hydazz/iasis/hardware/case/README.md

# Iasis case

A printed case with a screw-fastened lid and captive button. Choose a plain lid or one for an Adafruit 938 STEMMA QT OLED. The longer CM5 version holds the main board and carrier together.

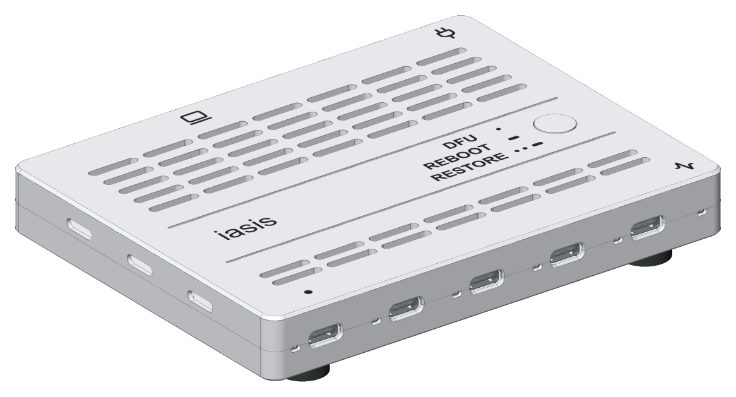
[picture p1: hardware/case/preview/case.png]
Iasis enclosure


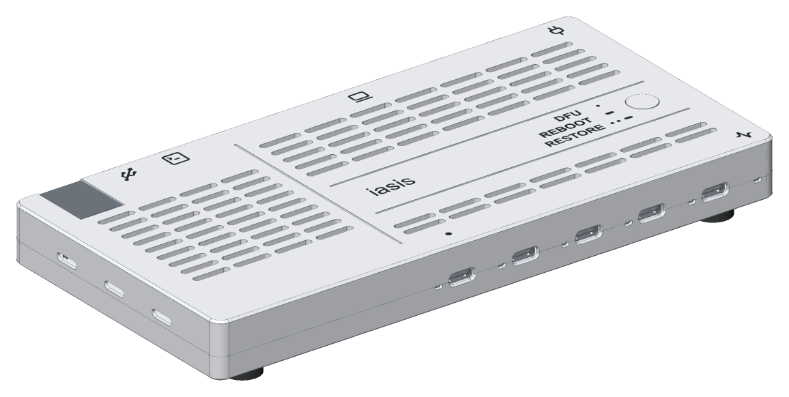
[picture p2: hardware/case/preview/case-cm5.png]
Iasis CM5 enclosure


| Case | Printed body size |
| --- | --- |
| Main board, plain lid | 136 × 104.6 × 17.1 mm |
| Main board, OLED lid  | 136 × 104.6 × 19.6 mm |
| CM5, plain lid | 212.6 × 104.6 × 20.1 mm |
| CM5, OLED lid | 212.6 × 104.6 × 20.1 mm |

## Generate the parts

Install the [development tools](../../README.md#build), including KiCad 10, then run from the repository root:

```sh
mise run //hardware/case:build
```

The build exports both populated boards and writes the case parts to `build/case/iasis/`:

| File | Part / print orientation |
| --- | --- |
| `print/tray.stl` | Tray, floor down |
| `print/cover-passive.stl` / `print/cover-display.stl` | Lid, top down |
| `print/button-passive.stl` / `print/button-display.stl` | Matching button, face down |
| `print/cover-*-lettering.stl` | Optional aligned lid inlays |
| `print/cm5-*.stl` | Corresponding CM5 parts; uses the same feet |
| `iasis-case.step` / `iasis-cm5-case.step` | Assemblies with both lid options |

The STLs are already oriented for printing. The STEP assemblies include screw, nut and purchased-foot envelopes; these are not printed parts.

## Hardware

Both sizes use the same hardware.

| Quantity | Part |
| --- | --- |
| 4 | M3 × 15 mm pan-head screws and M3 hex nuts |
| 4, OLED only | M2.5 × 4 mm pan-head screws |
| 4 | Small self-adhesive rubber feet |

Use the listed screw lengths to avoid reaching the lid's outer face.

## Print and assemble

Use PLA, a 0.4 mm nozzle, 0.20 mm layers and no supports. For multicolour markings, import the lid and matching lettering STL as parts of one object, retain their positions and assign filaments. Omit the lettering STL for recessed text.

1. Slide four M3 nuts into the inward-facing slots in the lid's outer mounting posts.
2. Set the PCB on the tray's locating pegs and fit the button from inside the lid.
3. Lower the lid onto the tray, engaging the end guides. Keep the nuts seated while handling the lid.
4. Fit the four 15 mm screws from underneath. Tighten by hand until the seam closes; the screws fasten the shell without clamping the PCB.
5. Stick four rubber feet near the corners of the flat underside, leaving the screw heads accessible.

To open, remove the four underside screws and lift the lid straight up. The feet provide clearance beneath the screw heads and can stay attached. The empty case also closes without the PCB. BOOTSEL and RESET are under the lid. The dot marks port 1; [button gestures](../../README.md#use) are printed beside the button.

### OLED assembly

With the lid face down, place the OLED on its four mounting posts, with the flex edge toward the target ports. Fit four M2.5 × 4 mm screws through the PCB's corner holes into the printed posts. Tighten gently by hand until the PCB is held against the supports. Keep pressure off the glass.

Connect the Qwiic cable before closing. The display can stay attached when opening the case.

### CM5 assembly

| Cooler fit | Dimension |
| --- | --- |
| Model | Waveshare CM4-HEATSINK, SKU 19623 |
| Body | 55 × 40 × 5 mm |
| Mounting allowance above module PCB | 3 mm |

Check the cooler's spacers and thermal-pad contact before assembly. Taller spacers need a taller lid.

Disconnect power before assembly or removal.

1. Fit the cooler screws from below.
2. Stick the RTC battery into the tray recess. Route its cable along the channel and pass the plug between the boards before joining them.
3. Align the boards' rear edges and connector pins, join the boards and lower them onto the pegs. Keep the wires side by side in the board gap.
4. Connect the battery to J104, tuck the cable clear of the lid and [enable charging](../boards/cm5/README.md#rtc-battery).

To remove the battery, unplug J104 and separate the boards before feeding the plug back through the gap.

## CAD tools

The case is generated with build123d. These tasks use the root Python environment:

| Task | Purpose |
| --- | --- |
| `mise run //hardware/case:test` | Check solids, board clearances, USB access and moving parts |
| `mise run //hardware/case:preview`  | Refresh the two images; requires a working graphics driver  |
| `mise run //hardware/case:view` | Open in OCP CAD Viewer |
| `mise run //hardware/case:view-cm5` | Open the CM5 assembly |

In the viewer, show one lid at a time under Cover. The [Lucide icons](src/iasis_case/icons/NOTICE) retain their licence and source notices.
