hydazz/iasis/hardware/boards/cm5/board.png

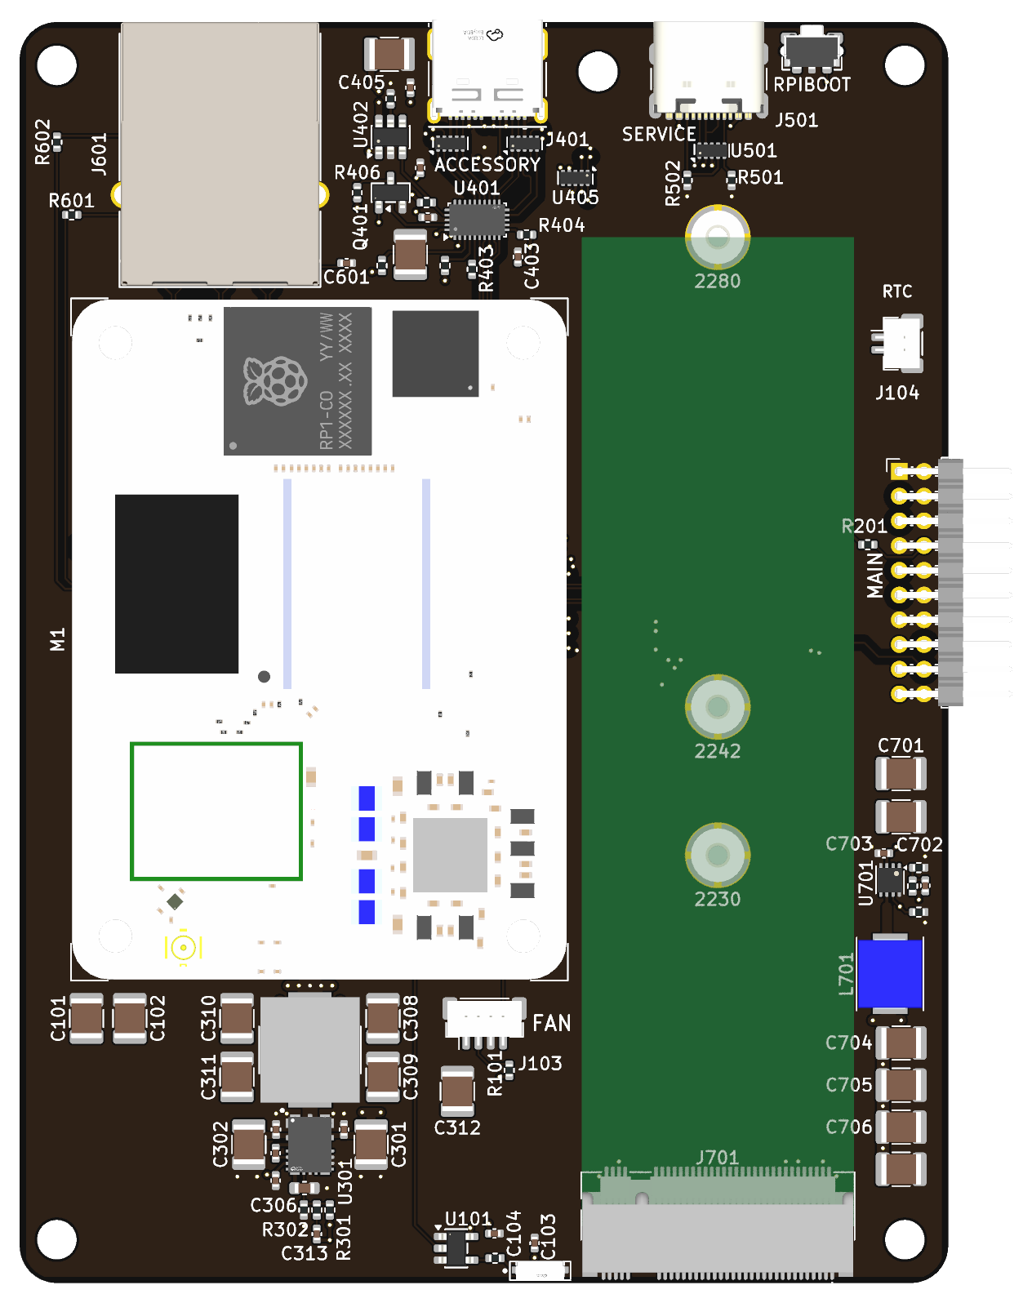
hardware/boards/cm5/board.png
