hydazz/iasis/hardware/tools/jlc_corrections.csv

lcsc | footprint | rotation | x | y
C134092 | Connector_USB:USB_C_Receptacle_Molex_105450-0101 | 0 | 0.0 | -0.334
C5184243 | Iasis:GCT_USB4105_GF_A_120 | 0 | 0.0 | -1.302
C8545 | Package_TO_SOT_SMD:SOT-23 | 180 | 0 | 0
C22466768 | Package_SO:Vishay_PowerPAK_1212-8_Single | 270 | -0.538226 | -0.016637
C7422903 | Package_SO:Vishay_PowerPAK_1212-8_Single | 270 | 0.165 | 0
C507223 | Package_TO_SOT_SMD:SOT-353_SC-70-5 | 180 | 0 | 0
C10096 | Package_TO_SOT_SMD:SOT-23-5 | 180 | 0 | 0
C544517 | Package_DFN_QFN:DHVQFN-20-1EP_2.5x4.5mm_P0.5mm_EP1x3mm | 270 | 0 | 0
C106794 | Package_SON:USON-10_2.5x1.0mm_P0.5mm | 270 | 0 | 0
C132291 | Package_DFN_QFN:WQFN-14-1EP_2.5x2.5mm_P0.5mm_EP1.45x1.45mm | 270 | 0 | 0
C2673275 | Package_DFN_QFN:UQFN-16_1.8x2.6mm_P0.4mm | 270 | 0 | 0
C3236215 | Package_TO_SOT_SMD:Texas_DDF0008A_SOT-8_1.6x2.9mm_P0.65mm | 270 | 0 | 0
C544399 | Iasis:HTSSOP-16-1EP_4.4x5mm_P0.65mm_EP3.4x5mm_Mask2.66x2.46mm_ThermalVias | 270 | 0 | 0
C2070918 | Package_DFN_QFN:DFN-8-1EP_2x2mm_P0.5mm_EP0.9x1.7mm | 270 | 0 | 0
C43698 | Package_TO_SOT_SMD:SOT-23-6 | 180 | 0 | 0
C555456 | Package_DFN_QFN:Texas_RGE0024C_VQFN-24-1EP_4x4mm_P0.5mm_EP2.1x2.1mm | 270 | 0 | 0
C7484 | Package_TO_SOT_SMD:SOT-23-5 | 180 | 0 | 0
C181499 | Package_DFN_QFN:VQFN-16-1EP_3x3mm_P0.5mm_EP1.45x1.45mm | 270 | 0 | 0
C5948 | Package_SO:TSSOP-16_4.4x5mm_P0.65mm | 270 | 0 | 0
C548572 | Package_SO:VSSOP-8_2.3x2mm_P0.5mm | 270 | 0 | 0
C2158037 | Package_TO_SOT_SMD:SOT-23-6 | 180 | 0 | 0
C3198089 | CM5:TI_RPH0016A | 0 | 0 | 0.132
C165155 | Package_DFN_QFN:Texas_RNH0030A_WQFN-30-1EP_2.5x4.5mm_P0.4mm_EP1.2x3.2mm | 270 | 0 | 0
C2158038 | Package_TO_SOT_SMD:SOT-23-6 | 270 | 0 | 0
C138714 | Package_SON:USON-10_2.5x1.0mm_P0.5mm | 270 | 0 | 0
C160390 | Connector_JST:JST_SH_BM04B-SRSS-TB_1x04-1MP_P1.00mm_Vertical | 0 | 0 | 0.062
C160388 | Connector_JST:JST_SH_BM02B-SRSS-TB_1x02-1MP_P1.00mm_Vertical | 180 | 0 | 0.062
C110293 | Button_Switch_SMD:SW_Push_1P1T-MP_NO_Horizontal_Alps_SKRTLAE010 | 0 | 0 | 0.075
C19268939 | Connector_PinSocket_2.00mm:PinSocket_2x10_P2.00mm_Horizontal | 270 | -1 | 9
C2906016 | Connector_PinHeader_2.00mm:PinHeader_2x10_P2.00mm_Horizontal | 90 | 1 | 9
C46061833 | Package_DFN_QFN:Texas_DSQ0010A_WSON-10-1EP_2x2mm_P0.4mm_EP0.9x1.5mm | 270 | 0 | 0
