hydazz/iasis/hardware/boards/cm5/cm5.kicad_pcb

## KiCad design hardware/boards/cm5/cm5.kicad_pcb (2026-11-10)

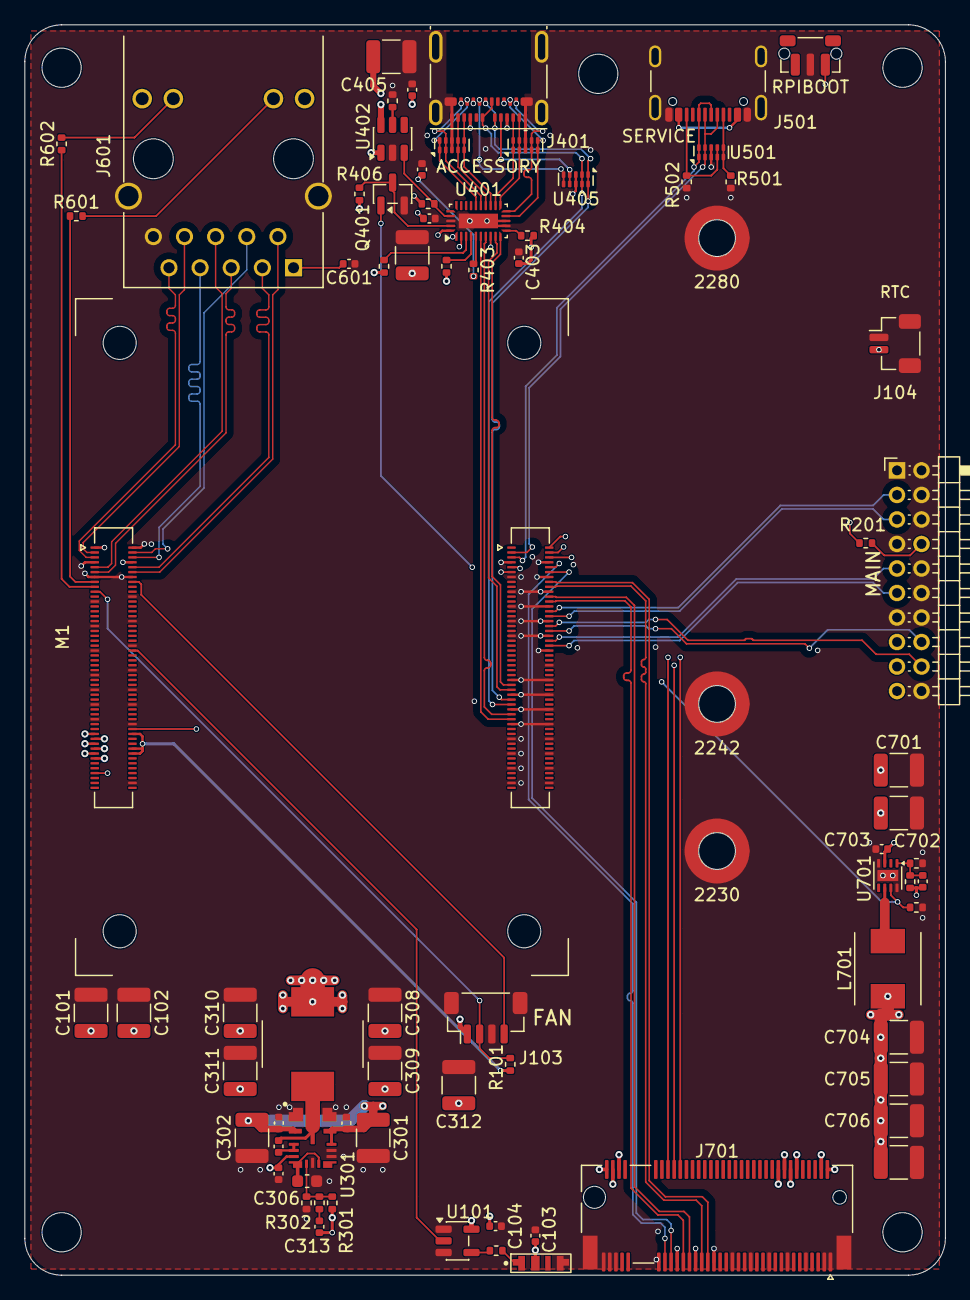
[picture p5: board cm5.kicad_pcb from above]

Board: 6 copper layers, 75.1 x 102.0 mm, 84 parts (0 on the bottom side), 79 nets.

Parts:
C101, C102, C308, C309, C310, C311, C312, C401, C405, C701, C702, C704, C705, C706, C707: 22u 16V X7R; C_1210_3225Metric
C103, C104, C305, C307, C402, C403, C404, C406, C601, C703: 100n; C_0402_1005Metric
C301, C302: 10u 50V X7R; C_1210_3225Metric
C303, C304: 100n 50V X7R; C_0402_1005Metric
C306: 1u 10V X7R; C_0603_1608Metric
C313: 10p C0G; C_0402_1005Metric
C708: 4.7n; C_0402_1005Metric
D101: SK6812SIDE-A; OPSCO_SK6812SIDE-A
H1, H2, H3, H4, H5: M3; MountingHole_3.2mm_M3
H701, H702, H703: 9774025243R; Mounting_Wuerth_WA-SMSI-M2_H2.5mm_9774025243
J101, J102: 10164227-1001A1RLF; Hirose_DF40C-100DS-0.4V_2x50_P0.4mm
J103: BM04B-SRSS-TB; JST_SH_BM04B-SRSS-TB_1x04-1MP_P1.00mm_Vertical
J104: BM02B-SRSS-TB; JST_SH_BM02B-SRSS-TB_1x02-1MP_P1.00mm_Vertical
J201: PZ200-2-10-W; PinHeader_2x10_P2.00mm_Horizontal
J401: 1054500101; USB_C_Receptacle_Molex_105450-0101
J501: USB4105-GF-A-120; GCT_USB4105_GF_A_120
J601: HR911130A; HanRun_HR911130A
J701: 1-2199230-5; TE_M.2_M_2x38-1MP_P0.5mm
L301: 3.3u 17A; L_PROD_PSPMAA0805
L701: SRP5030CC-2R2M; Bourns_SRP5030CC
M1: CM5; RaspberryPi_CM5
Q401: 2N7002; SOT-23
R101, R701: 10k; R_0402_1005Metric
R102: 33; R_0402_1005Metric
R201: 1k; R_0402_1005Metric
R301: 100k 0.1%; R_0402_1005Metric
R302: 24.3k 0.1%; R_0402_1005Metric
R303, R501, R502: 5.1k; R_0402_1005Metric
R401: 4.7k; R_0402_1005Metric
R402: 499k 1%; R_0402_1005Metric
R403: 909k 1%; R_0402_1005Metric
R404, R405: 200k 1%; R_0402_1005Metric
R406, R703: 100k; R_0402_1005Metric
R407: 15k 1%; R_0402_1005Metric
R601, R602: 470; R_0402_1005Metric
R702: 2.2k; R_0402_1005Metric
SW501: SKRTLAE010; SW_Push_1P1T-MP_NO_Horizontal_Alps_SKRTLAE010
U101: SN74AHCT1G125DBVR; SOT-23-5
U301: LM61480RPHR; TI_RPH0016A
U401: HD3SS3220RNHR; Texas_RNH0030A_WQFN-30-1EP_2.5x4.5mm_P0.4mm_EP1.2x3.2mm
U402: AP22652W6-7; SOT-23-6
U403, U404: TPD4E02B04DQAR; USON-10_2.5x1.0mm_P0.5mm
U405, U501: TPD4E05U06DQAR; USON-10_2.5x1.0mm_P0.5mm
U701: AP3441SHE-7B; DFN-8-1EP_2x2mm_P0.5mm_EP0.9x1.7mm

Connections:
5V: C101.1, C102.1, C103.1, C104.1, C307.1, C308.1, C309.1, C310.1, C311.1, C312.1, C313.1, C401.1, C402.1, C404.1, C701.1, C702.1, C703.1, D101.2 (VDD), J101.77 (5V), J101.79 (5V), J101.81 (5V), J101.83 (5V), J101.85 (5V), J101.87 (5V), J103.1, L301.2, R301.1, R401.1, R402.1, R405.1, R406.1, U101.5 (VCC), U301.5 (BIAS), U401.30 (VDD5), U402.1 (IN), U701.3 (VIN)
/5 V supply/BUCK_FB: R301.2, R302.1, R303.2, U301.7 (FB)
/5 V supply/BUCK_SW: C305.1, L301.1, U301.16 (SW)
/Accessory port/CC1: J401.A5 (CC1), U401.2 (CC1), U405.4 (D2+), U405.7 (NC)
/Accessory port/CC2: J401.B5 (CC2), U401.1 (CC2), U405.5 (D2-), U405.6 (NC)
/Accessory port/CC_EN_N: Q401.3 (D), R406.2, U401.29 (ENn_CC)
/Accessory port/CURRENT_MODE: R402.2, U401.3 (CURRENT_MODE)
/Accessory port/DIR: R404.2, U401.11 (DIR)
/Accessory port/ID: R405.2, U401.27 (ID), U402.3 (~EN)
/Accessory port/PORT: R401.2, U401.4 (PORT)
/Accessory port/RX1_N: J401.B10 (RX1-), U401.14 (RX1n), U403.5 (D2-), U403.6 (NC)
/Accessory port/RX1_P: J401.B11 (RX1+), U401.15 (RX1p), U403.4 (D2+), U403.7 (NC)
/Accessory port/RX2_N: J401.A10 (RX2-), U401.18 (RX2n), U404.5 (D2-), U404.6 (NC)
/Accessory port/RX2_P: J401.A11 (RX2+), U401.19 (RX2p), U404.4 (D2+), U404.7 (NC)
/Accessory port/TX1_N: J401.A2 (TX1+), U401.16 (TX1n), U403.2 (D1-), U403.9 (NC)
/Accessory port/TX1_P: J401.A3 (TX1-), U401.17 (TX1p), U403.1 (D1+), U403.10 (NC)
/Accessory port/TX2_N: J401.B2 (TX2+), U401.20 (TX2n), U404.2 (D1-), U404.9 (NC)
/Accessory port/TX2_P: J401.B3 (TX2-), U401.21 (TX2p), U404.1 (D1+), U404.10 (NC)
/Accessory port/VBUS_ILIM: R407.1, U402.5 (ILIM)
/Compute module/FAN_PWM: J101.19 (Fan_PWM), J103.2, R101.2
/Compute module/FAN_TACH: J101.16 (Fan_Tacho), J103.4
/Compute module/LED_DATA: J101.44 (GPIO10), U101.2
/Compute module/RTC_BAT: J101.76 (VBAT), J104.2
/NVMe/NVME_FB: C708.2, R701.2, R702.1, U701.1 (FB)
/NVMe/NVME_LX: L701.1, U701.6 (LX)
/Service port/CC1: J501.A5 (CC1), R501.1, U501.5 (D2-), U501.6 (NC)
/Service port/CC2: J501.B5 (CC2), R502.1, U501.4 (D2+), U501.7 (NC)
/Service port/VBUS_UNUSED: J501.A4 (VBUS), J501.A9 (VBUS), J501.B4 (VBUS), J501.B9 (VBUS)
/Side link/CM5_HOST: J201.8, R201.2
ACC_D_N: J102.65 (USB3-1-DM), J401.A7 (D-), J401.B7 (D-), U405.2 (D1-), U405.9 (NC)
ACC_D_P: J102.63 (USB3-1-DP), J401.A6 (D+), J401.B6 (D+), U405.1 (D1+), U405.10 (NC)
ACC_RX_N: J102.57 (USB3-1-RX_N), U401.10 (RXn)
ACC_RX_P: J102.59 (USB3-1-RX_P), U401.9 (RXp)
ACC_TX_N: J102.69 (USB3-1-TX_N), U401.7 (TXn)
ACC_TX_P: J102.71 (USB3-1-TX_P), U401.6 (TXp)
ACC_VBUS: C405.1, C406.1, J401.A4 (VBUS), J401.A9 (VBUS), J401.B4 (VBUS), J401.B9 (VBUS), R403.2, U402.6 (OUT)
CM5_3V3: C403.1, J101.78 (GPIO_VREF), J101.84 (CM5_3V3), J101.86 (CM5_3V3), J601.11 (LEDG+), J601.14 (LEDY+), R101.1, R404.1, U401.8 (VCC33)
ETH_LED2_N: J101.17 (Ethernet_nLED2), R602.2
ETH_LED3_N: J101.15 (Ethernet_nLED3), R601.2
GND: C101.2, C102.2, C103.2, C104.2, C301.2, C302.2, C303.2, C304.2, C306.2, C307.2, C308.2, C309.2, C310.2, C311.2, C312.2, C401.2, C402.2, C403.2, C404.2, C405.2, C406.2, C601.2, C701.2, C702.2, C703.2, C704.2, C705.2, C706.2, C707.2, D101.4 (GND), H701.1 (1_1), H702.1 (1_1), H703.1 (1_1), J101.1 (GND), J101.2 (GND), J101.7 (GND), J101.8 (GND), J101.13 (GND), J101.14 (GND), J101.22 (GND), J101.23 (GND), J101.32 (GND), J101.33 (GND), J101.42 (GND), J101.43 (GND), J101.52 (GND), J101.53 (GND), J101.59 (GND), J101.60 (GND), J101.65 (GND), J101.66 (GND), J101.71 (GND), J101.74 (GND), J101.98 (GND), J102.7 (GND), J102.8 (GND), J102.13 (GND), J102.14 (GND), J102.19 (GND), J102.20 (GND), J102.25 (GND), J102.26 (GND), J102.31 (GND), J102.32 (GND), J102.37 (GND), J102.38 (GND), J102.44 (GND), J102.50 (GND), J102.55 (GND), J102.56 (GND), J102.61 (GND), J102.62 (GND), J102.67 (GND), J102.68 (GND), J102.73 (GND), J102.74 (GND), J102.79 (GND), J102.80 (GND), J102.85 (GND), J102.86 (GND), J102.91 (GND), J102.92 (GND), J102.97 (GND), J102.98 (GND), J103.3, J103.MP (MountPin), J104.1, J104.MP (MountPin), J201.1, J201.2, J201.4, J201.6, J201.7, J201.10, J201.12, J201.13, J201.14, J201.20, J401.A1 (GND), J401.A12 (GND), J401.B1 (GND), J401.B12 (GND), J401.SH (SHIELD), J501.A1 (GND), J501.A12 (GND), J501.B1 (GND), J501.B12 (GND), J501.SH (SHIELD), J601.10 (CHASSIS), J601.SH, J701.1 (GND), J701.3 (GND), J701.9 (GND), J701.15 (GND), J701.21 (GND), J701.27 (GND), J701.33 (GND), J701.39 (GND), J701.45 (GND), J701.51 (GND), J701.57 (GND), J701.71 (GND), J701.73 (GND), J701.75 (GND), J701.MP (SH), Q401.2 (S), R302.2, R407.2, R501.2, R502.2, R702.2, R703.2, SW501.2, U101.1, U101.3 (GND), U301.1 (PGND2), U301.8 (AGND), U301.11 (SPSP), U301.12 (SYNC/MODE), U301.15 (PGND1), U401.12 (ENn_MUX), U401.13 (GND), U401.28 (GND), U401.31 (GND), U402.2 (GND), U403.3 (GND), U403.8 (GND), U404.3 (GND), U404.8 (GND), U405.3 (GND), U405.8 (GND), U501.3 (GND), U501.8 (GND), U701.4 (PGND), U701.8 (SGND), U701.9 (SGND)
MDI0_N: J101.10 (Ethernet_Pair0_N), J601.3 (MDI0-)
MDI0_P: J101.12 (Ethernet_Pair0_P), J601.2 (MDI0+)
MDI1_N: J101.6 (Ethernet_Pair1_N), J601.7 (MDI1-)
MDI1_P: J101.4 (Ethernet_Pair1_P), J601.4 (MDI1+)
MDI2_N: J101.9 (Ethernet_Pair2_N), J601.6 (MDI2-)
MDI2_P: J101.11 (Ethernet_Pair2_P), J601.5 (MDI2+)
MDI3_N: J101.5 (Ethernet_Pair3_N), J601.9 (MDI3-)
MDI3_P: J101.3 (Ethernet_Pair3_P), J601.8 (MDI3+)
NVME_3V3: C704.1, C705.1, C706.1, C707.1, C708.1, J701.2 (3.3V), J701.4 (3.3V), J701.12 (3.3V), J701.14 (3.3V), J701.16 (3.3V), J701.18 (3.3V), J701.70 (3.3V), J701.72 (3.3V), J701.74 (3.3V), L701.2, R701.1
unnamed: C313.2, R303.1
unnamed: D101.1 (DIN), R102.2
unnamed: C601.1, J601.1 (CT)
unnamed: J601.12 (LEDG-), R601.1
unnamed: J601.13 (LEDY-), R602.1
unnamed: R102.1, U101.4
unnamed: C305.2, U301.3 (RBOOT), U301.4 (CBOOT)
unnamed: C306.1, U301.6 (VCC), U301.9 (RT)
unnamed: R403.1, U401.5 (VBUS_DET)
OTG_D_N: J102.3 (USB_N), J501.A7 (D-), J501.B7 (D-), U501.2 (D1-), U501.9 (NC)
OTG_D_P: J102.5 (USB_P), J501.A6 (D+), J501.B6 (D+), U501.1 (D1+), U501.10 (NC)
PCIE_CLKREQ_N: J102.2 (PCIe_CLK_nREQ), J701.52 (~CLKREQ)
PCIE_CLK_N: J102.12 (PCIe_CLK_N), J701.53 (REFCLKn)
PCIE_CLK_P: J102.10 (PCIe_CLK_P), J701.55 (REFCLKp)
PCIE_PWR_EN: J102.6 (PCIE_PWR_EN), R703.1, U701.7 (EN)
PCIE_RST_N: J102.9 (PCIe_nRST), J701.50 (~PERST)
PCIE_RX_N: J102.16 (PCIe_RX_P), J701.41 (PERn0/SATA-B+)
PCIE_RX_P: J102.18 (PCIe_RX_N), J701.43 (PERp0/SATA-B-)
PCIE_TX_N: J102.22 (PCIe_TX_P), J701.47 (PETn0/SATA-A-)
PCIE_TX_P: J102.24 (PCIe_TX_N), J701.49 (PETp0/SATA-A+)
PCIE_WAKE_N: J102.4 (PCIE_nWAKE), J701.54 (~PEWAKE)
RPIBOOT_N: J101.93 (nRPIBOOT), SW501.1
SIDE_BUS: C301.1, C302.1, C303.1, C304.1, J201.15, J201.17, J201.19, U301.2 (VIN2), U301.13 (EN), U301.14 (VIN1)
SIDE_D_N: J102.36 (USB3-0-DM), J201.16
SIDE_D_P: J102.34 (USB3-0-DP), J201.18
SIDE_RX_N: J102.42 (USB3-0-TX_P), J201.11
SIDE_RX_P: J102.40 (USB3-0-TX_N), J201.9
SIDE_TX_N: J102.30 (USB3-0-RX_P), J201.5
SIDE_TX_P: J102.28 (USB3-0-RX_N), J201.3
VBUS_EN: J102.11 (VBUS_EN), Q401.1 (G), R201.1
