hydazz/iasis/hardware/case/src/iasis_case/case.py

"""Iasis enclosure: a lower tray and upper cover split through the USB-C ports.

The board sits on locating posts between a tray and removable cover. Passive and OLED
covers share the tray. Flush top markings are separate solids for multicolour printing.
The CM5 build's enclosure holds the main board and the CM5 side board the same way, as
one board (side.py).

Geometry is in board coordinates (board.py). The board STEP supplies the outline, the
holes, every connector, light and button; the numbers here are fit, form and the parts
the STEP does not contain.
"""

import math
from dataclasses import dataclass, field
from functools import cached_property
from pathlib import Path
from typing import cast

from build123d import (
    Align,
    Axis,
    BoundBox,
    Box,
    Circle,
    Compound,
    Cone,
    Cylinder,
    Face,
    FontStyle,
    GeomType,
    Kind,
    Part,
    Plane,
    Pos,
    Rectangle,
    RectangleRounded,
    Sketch,
    SlotOverall,
    Text,
    Vector,
    chamfer,
    extrude,
    fillet,
)

from . import retention
from .artwork import icon
from .battery import Battery
from .battery import seat as battery_seat
from .board import Board, load
from .retention import DisplayMount, Fastener
from .side import Pair, pair
from .side import assemble as side_board

# Fit
CLEARANCE = 0.3  # board edge to inner wall
PORT_FIT = 0.30  # each side of the metal shell
PORT_ERROR = 0.15  # additional axial print and connector-placement allowance
SHOULDER_GAP = 0.05  # minimum fully seated plug shoulder to exterior wall
HEADROOM = 1.2  # tallest part or envelope to the cover's inner top
MIN_GAP = 0.3  # smallest gap between the case and a part

# Form
WALL = 1.2
TOP = 1.6
FLOOR = 2.0
STANDOFF = 3.0  # clear space under the board
TOP_CHAMFER = 0.8  # 45 degrees, supported when the cover prints top down
BASE_CHAMFER = 0.6
PORT_EDGE_R = 0.5  # outer edge of each USB-C opening
FOOT_D, FOOT_H = 8.0, 3.0  # adhesive bumper envelope

# Board support
HOLE_D = 3.2  # the board's M3 drill, which identifies the case holes
LOCATOR_D, LOCATOR_OVER = 2.9, 0.8
BOARD_HOLD_GAP = 0.15
PILLAR_D = 6.6  # inside the mounting holes' 7 mm courtyard
STANDOFF_D = 7.0

PORTS = {  # reference: (kind, label)
    "J401": ("usb-c", "1"),
    "J501": ("usb-c", "2"),
    "J601": ("usb-c", "3"),
    "J701": ("usb-c", "4"),
    "J801": ("usb-c", "5"),
    "J901": ("usb-c", "HOST"),
    "J1001": ("usb-c", "POWER"),
}

# Minimum fully mated shoulder-to-mouth distances, not generic receptacle depths.
# Molex SD-105450-001: USB-IF exposed shell 6.51 min - mouth depth (4.70 + 0.20).
# GCT USB4105 drawing: 1.85 min in the plug/receptacle mating view.
MATED_SHOULDER = {ref: 1.85 if ref == "J1001" else 6.51 - 4.90 for ref in PORTS}

# The CM5 build adds the side board's rear edge (side.py prefixes its references): the
# accessory port is the Molex receptacle, the service port the GCT, and nRPIBOOT is a
# side-actuated button behind a pinhole.
SIDE_PORTS = {
    "S:J401": ("usb-c", "ACCESSORY"),
    "S:J501": ("usb-c", "SERVICE"),
    "S:J601": ("rj45", "ETHERNET"),
    "S:SW501": ("pin", "RPIBOOT"),
}
MATED_SHOULDER |= {"S:J401": 6.51 - 4.90, "S:J501": 1.85}
PIN_D = 1.6

# Side-emitting LEDs at the board edge shine through windows no larger than their
# emitting face. A captive round cap operates the target-control switch.
LIGHTS = ("D1170", "D1171", "D1172", "D1173", "D1174", "D1175")  # status, targets
WINDOW = (3.0, 1.6)
BUTTON = "SW1171"
BUTTON_D, BUTTON_FIT = 10.0, 0.25  # radial fit in the cover
BUTTON_FLANGE_D = 13.0
BUTTON_FLANGE_H = (BUTTON_FLANGE_D - BUTTON_D) / 2  # printable 45 degree shoulder
BUTTON_ROOF_GAP, BUTTON_PROUD, BUTTON_PIN = 0.2, 0.2, 4.0
BUTTON_TRAVEL = 0.6  # case clearance envelope, not the switch's permitted stroke


@dataclass(frozen=True)
class Display:
    """An I2C OLED module held glass up under the top, on a cable to the
    board's JST-SH socket. Positions are from the module PCB's centre, x along the case,
    y toward the rear."""

    name: str
    pcb: tuple[float, float, float]  # x, y, thickness
    glass: tuple[float, float, float, float, float]  # centre x, y; size x, y; thickness
    active: tuple[float, float, float, float]  # visible pixels: centre x, y; size x, y
    back: float  # tallest part under the PCB, connector included
    holes: tuple[tuple[float, float], ...]


# Adafruit 938, from its board file, fab print and STEP model. The flex edge faces the
# front, so the picture reads from in front of the box.
OLED = Display(
    name="Adafruit 938 1.3in 128x64 OLED",
    pcb=(35.56, 33.02, 1.57),
    glass=(0.0, 0.06, 34.5, 23.0, 1.5),
    active=(0.0, 2.11, 29.42, 14.70),
    back=3.0,  # the JST-SH sockets
    holes=tuple((sx * 15.24, sy * 13.97) for sx in (-1, 1) for sy in (-1, 1)),
)
DISPLAY_OVER = ("J501", "J601")  # centred between ports 2 and 3
WINDOW_MARGIN = 0.5  # window beyond the active area, each side
WINDOW_BEVEL = 1.4  # 45 degree chamfer round the window's outer edge
GLASS_GAP = 0.4  # glass face to the inside of the top; clears the tape over the flex
DISPLAY_HOLE_D = 2.5


COVERS = {"passive": None, "display": OLED}

# Top ventilation.
SLOT_W = 2.6

# Marks
TEXT_DEPTH = 0.4  # two 0.20 mm layers, flush with the top
TEXT_SIZE = 4.5
WORDMARK = "iasis"
WORDMARK_SIZE = 8.0

BASE = (Align.CENTER, Align.CENTER, Align.MIN)  # centred, standing on the given point
Z_UP = (0, 0, 1)  # the outline comes from the board's underside and faces down


@dataclass(frozen=True)
class Opening:
    """A hole in the front or rear wall for the part `ref`, centred on (x, z). y_face is
    the part's face toward that wall, y_wall the wall's outer face."""

    ref: str
    kind: str  # usb-c, rj45, pin or light
    label: str | None
    x: float
    z: float
    width: float
    height: float
    radius: float
    y_face: float
    y_wall: float

    @property
    def front(self) -> bool:
        return self.y_wall < 0

    @property
    def inward(self) -> int:
        """+1 or -1: the y direction from this wall into the box."""
        return 1 if self.front else -1

    def plane(self, y: float) -> Plane:
        """A plane at depth y on the opening's centre, facing out of the box, with x
        reading left to right from outside and y up."""
        return Plane(origin=(self.x, y, self.z), x_dir=(self.inward, 0, 0),
                     z_dir=(0, -self.inward, 0))  # fmt: skip

    def profile(self) -> Sketch:
        if self.kind == "light":
            return SlotOverall(self.width, self.height)
        return RectangleRounded(self.width, self.height, self.radius)


@dataclass
class Layout:
    """Everything the parts are built from, derived once from the board."""

    board: Board
    seat: float  # top surface the parts sit on
    cavity: Face  # cover inner outline, z = 0
    length: float  # outer
    width: float
    port_wall: float
    z_bottom: float  # tray underside
    corner_r: float  # outer vertical corners: the board's plus clearance and wall
    holes: list[Vector]
    parts_top: float  # tallest part beneath the roof; the RJ45 passes through it
    split: float
    ports: dict[str, tuple[str, str]] = field(default_factory=lambda: dict(PORTS))
    battery: Battery | None = None
    _roofs: dict[Display | None, float] = field(default_factory=dict, init=False, repr=False)

    @property
    def y_front(self) -> float:
        return -self.width / 2

    @property
    def y_rear(self) -> float:
        return self.width / 2

    @property
    def divider_x(self) -> float | None:
        return self.board.join_x if isinstance(self.board, Pair) else None

    @property
    def control_left(self) -> float:
        return self.divider_x + 6 if self.divider_x is not None else -self.length / 2 + 10

    @cached_property
    def openings(self) -> list[Opening]:
        out = [_port(self, ref, kind, label) for ref, (kind, label) in self.ports.items()]
        out += [_light(self, ref) for ref in LIGHTS]
        return out

    @cached_property
    def display_x(self) -> float:
        return sum(self.board.box(ref).center().X for ref in DISPLAY_OVER) / len(DISPLAY_OVER)

    @cached_property
    def fasteners(self) -> tuple[Fastener, ...]:
        left, right = min(h.X for h in self.holes), max(h.X for h in self.holes)
        mounts = []
        for edge, angle in ((left, 0), (right, 180)):
            end = [h for h in self.holes if abs(h.X - edge) < 1]
            for h in (min(end, key=lambda h: h.Y), max(end, key=lambda h: h.Y)):
                mounts.append(Fastener(h.X, h.Y, self.z_bottom, 15, angle))
        return tuple(mounts)

    def fastener_at(self, hole: Vector) -> Fastener | None:
        return next(
            (f for f in self.fasteners if math.hypot(f.x - hole.X, f.y - hole.Y) < 0.01), None
        )

    def top_inside(self, display: Display | None = None) -> float:
        if display in self._roofs:
            return self._roofs[display]
        top = self.parts_top + HEADROOM
        if display:
            # Only components beneath the module determine its required height.
            w, h, thickness = display.pcb
            boxes = [self.board.box(ref, exact=False) for ref in self.board.parts]
            local_top = max(
                [self.seat]
                + [
                    b.max.Z
                    for b in boxes
                    if b.min.X < self.display_x + w / 2 + MIN_GAP
                    and b.max.X > self.display_x - w / 2 - MIN_GAP
                    and b.min.Y < h / 2 + MIN_GAP
                    and b.max.Y > -h / 2 - MIN_GAP
                ]
            )
            top = max(
                top, local_top + MIN_GAP + display.back + thickness + display.glass[4] + GLASS_GAP
            )
        self._roofs[display] = math.ceil(top * 2) / 2
        return self._roofs[display]


@dataclass
class Cover:
    part: Part
    intrusions: dict[str, Part]  # solids that reach into the cavity, for the fit check
    display: Part | None  # the module's envelope
    markings: Compound
    button: Part
    fasteners: tuple[Fastener, ...]
    display_mount: DisplayMount | None


def layout(
    board: Board,
    ports: dict[str, tuple[str, str]] = PORTS,
) -> Layout:
    required = set(ports) | set(LIGHTS) | {BUTTON}
    missing = required - board.parts.keys()
    if missing:
        raise ValueError("board STEP lacks enclosure references: " + ", ".join(sorted(missing)))
    size = board.size
    radii = [e.radius for e in board.outline().edges() if e.geom_type == GeomType.CIRCLE]
    corner = min(radii, default=0.0)
    # Both the nominal board gap and its full sideways movement consume recess.
    # Round down to a printable wall thickness, retaining the seating/error budget.
    wall_limit = min(
        MATED_SHOULDER[ref]
        - SHOULDER_GAP
        + abs(_mouth_y(board, ref))
        - size.Y / 2
        - 2 * CLEARANCE
        - PORT_ERROR
        for ref, (kind, _) in ports.items()
        if kind == "usb-c"
    )
    port_wall = min(WALL, math.floor((wall_limit + 1e-6) * 10) / 10)
    if port_wall < 0.8:
        raise ValueError(f"USB seating budget leaves only {port_wall:.1f} mm wall")
    return Layout(
        board=board,
        seat=board.body.bounding_box().max.Z,
        # Arc joins add zero-length arcs at the outline's tangent points, which mesh badly.
        cavity=Face(board.outline().outer_wire().offset_2d(CLEARANCE, kind=Kind.INTERSECTION)),
        length=size.X + 2 * (CLEARANCE + WALL),
        width=size.Y + 2 * (CLEARANCE + port_wall),
        port_wall=port_wall,
        z_bottom=-(STANDOFF + FLOOR),
        corner_r=corner + CLEARANCE + min(WALL, port_wall),
        holes=board.holes(HOLE_D),
        parts_top=max(
            board.box(ref, exact=False).max.Z
            for ref in board.parts
            if ports.get(ref, (None, None))[0] != "rj45"
        ),
        split=board.body.bounding_box().max.Z + 1.6,
        ports=dict(ports),
    )


def _facing(lay: Layout, ref: str) -> tuple[BoundBox, float, float]:
    """A part's exact box, the y of its face toward the nearer long wall, and the y of
    that wall's outer face."""
    bb = lay.board.box(ref)
    if bb.center().Y > 0:
        return bb, bb.max.Y, lay.y_rear
    return bb, bb.min.Y, lay.y_front


def _mouth_y(board: Board, ref: str) -> float:
    bb = board.box(ref)
    return bb.max.Y if bb.center().Y > 0 else bb.min.Y


def _nose(board: Board, ref: str) -> BoundBox:
    bb = board.box(ref)
    y_face = _mouth_y(board, ref)
    inward = -1 if y_face > 0 else 1
    # The nose section excludes shell anchors and solder tails from the opening.
    section = board.parts[ref] & (
        Pos(bb.center().X, y_face + inward * 0.05, bb.center().Z)
        * Box(bb.size.X + 2, 0.10, bb.size.Z + 2)
    )
    return section.bounding_box()


def _port(lay: Layout, ref: str, kind: str, label: str) -> Opening:
    _, y_face, y_wall = _facing(lay, ref)
    nose = _nose(lay.board, ref)
    if kind == "pin":  # centred on the actuator
        w = h = PIN_D
    else:
        w, h = nose.size.X + 2 * PORT_FIT, nose.size.Z + 2 * PORT_FIT
    corner = {"usb-c": 1.5, "rj45": 0.5}.get(kind, h / 2)  # pinholes are round
    return Opening(
        ref,
        kind,
        label,
        nose.center().X,
        nose.center().Z,
        w,
        h,
        min(h / 2 - 0.01, corner),
        y_face,
        y_wall,
    )


def _light(lay: Layout, ref: str) -> Opening:
    bb, y_face, y_wall = _facing(lay, ref)
    w, h = min(WINDOW[0], bb.size.X), min(WINDOW[1], bb.size.Z)
    return Opening(ref, "light", None, bb.center().X, bb.center().Z, w, h, h / 2, y_face, y_wall)


def _outline(lay: Layout) -> Sketch:
    return RectangleRounded(lay.length, lay.width, lay.corner_r)


def _foot_centres(lay: Layout) -> list[tuple[float, float]]:
    return [(x, y) for x in (-lay.length / 2 + 17, lay.length / 2 - 17) for y in (-42, 42)]


def foot() -> Part:
    """Purchased adhesive bumper envelope; not a printable part."""
    body = Cylinder(FOOT_D / 2, FOOT_H, align=BASE)
    body.label = "adhesive rubber bumper envelope"
    return cast(Part, body)


def feet(lay: Layout) -> list[Part]:
    body = foot()
    return [Pos(x, y, lay.z_bottom - FOOT_H) * body for x, y in _foot_centres(lay)]


def tray(lay: Layout) -> Part:
    """Lower tray, printed floor down, with open-top halves of the port openings."""
    z0 = lay.z_bottom
    body = extrude(Pos(0, 0, z0) * _outline(lay), amount=lay.split - z0)
    body = chamfer(body.edges().group_by(Axis.Z)[0], BASE_CHAMFER)
    body -= extrude(Pos(0, 0, z0 + FLOOR) * lay.cavity, amount=lay.split - z0 - FLOOR + 1, dir=Z_UP)
    body += Compound(
        [
            Pos(h.X, h.Y, z0 + FLOOR - 0.1) * Cylinder(STANDOFF_D / 2, STANDOFF + 0.1, align=BASE)
            for h in lay.holes
        ]
    )
    for h in lay.holes:
        if lay.fastener_at(h) is not None:
            continue
        body += Pos(h.X, h.Y, -0.1) * Cylinder(
            LOCATOR_D / 2, lay.seat + LOCATOR_OVER - 0.3, align=BASE
        )
        body += Pos(h.X, h.Y, lay.seat + LOCATOR_OVER - 0.4) * Cone(
            LOCATOR_D / 2, LOCATOR_D / 2 - 0.4, 0.4, align=BASE
        )
    body -= Compound([_wall_cut(o) for o in lay.openings])
    body -= Compound(retention.guide_pockets(lay.length / 2, lay.split))
    for f in lay.fasteners:
        body -= f.bore
    if lay.battery is not None:
        body -= lay.battery.pocket + lay.battery.channel
    body.label = "tray"
    # build123d's boolean annotations lose the result's dimensional subtype.
    return cast(Part, body)


def cover(lay: Layout, name: str, display: Display | None) -> Cover:
    top_in = lay.top_inside(display)
    top_out = top_in + TOP
    z0 = lay.split

    shell = extrude(Pos(0, 0, z0) * _outline(lay),
                    amount=top_out - z0)  # fmt: skip
    shell = chamfer(shell.edges().group_by(Axis.Z)[-1], TOP_CHAMFER)
    shell -= extrude(Pos(0, 0, z0 - 1) * lay.cavity, amount=top_in - z0 + 1, dir=Z_UP)

    # Pillars and display posts project from the roof into the cavity.
    intrusions: dict[str, Part] = {}
    intrusions |= {
        f"guide {i + 1}": p for i, p in enumerate(retention.guides(lay.length / 2, lay.split))
    }
    cuts: list[Part] = []
    # A hole nearer the edge than the pillar's radius gets a pillar cut flush with the board edge,
    # clear of the tray wall that rises beyond it.
    board_edge = Face(lay.cavity.outer_wire().offset_2d(-CLEARANCE, kind=Kind.INTERSECTION))
    edge = extrude(Pos(0, 0, lay.seat) * board_edge, amount=top_in - lay.seat + 1, dir=Z_UP)
    outside = extrude(Pos(0, 0, lay.seat) * _outline(lay), amount=top_in - lay.seat + 1)
    for i, h in enumerate(lay.holes):
        bottom = lay.seat + BOARD_HOLD_GAP
        if (f := lay.fastener_at(h)) is not None:
            stem_top = 4.2
            shoulder = stem_top + (retention.BOSS_D - PILLAR_D) / 2
            pillar = (
                Pos(h.X, h.Y, bottom) * Cylinder(PILLAR_D / 2, stem_top - bottom, align=BASE)
            ) & edge
            pillar += Pos(h.X, h.Y, stem_top) * Cone(
                PILLAR_D / 2, retention.BOSS_D / 2, shoulder - stem_top, align=BASE
            )
            pillar += Pos(h.X, h.Y, shoulder) * Cylinder(
                retention.BOSS_D / 2, top_in + 0.5 - shoulder, align=BASE
            )
            pillar = cast(Part, pillar & outside) - f.receiver_cut
            cuts.append(f.receiver_cut)
        else:
            pillar = Pos(h.X, h.Y, bottom) * Cylinder(
                PILLAR_D / 2, top_in - bottom + 0.5, align=BASE
            )
            pillar -= Pos(h.X, h.Y, bottom - 0.1) * Cylinder(
                (LOCATOR_D + 2 * CLEARANCE) / 2, LOCATOR_OVER + CLEARANCE, align=BASE
            )
            pillar &= edge
        intrusions[f"pillar {i + 1}"] = cast(Part, pillar)
    shell += Compound(list(intrusions.values()))

    cuts += [_wall_cut(o) for o in lay.openings]
    cuts += [extrude(Pos(0, 0, top_in - 1) * p, amount=TOP + 2) for p in _roof_openings(lay)]
    cuts += _top_slots(lay, top_in - 1, TOP + 2, display)
    cuts += _side_intakes(lay)
    cuts += _control_grooves(lay, top_out, display)
    sw = lay.board.box(BUTTON).center()
    cuts.append(
        Pos(sw.X, sw.Y, top_in - 1) * Cylinder(BUTTON_D / 2 + BUTTON_FIT, TOP + 2, align=BASE)
    )

    display_part = None
    display_mount = None
    if display:
        face = top_in - GLASS_GAP - display.glass[4]
        display_mount = DisplayMount(lay.display_x, face, top_in, display.pcb[2], display.holes)
        window, display_part = _display(lay, display, top_in, top_out)
        cuts += [window, *display_mount.pilots]
        shell += Compound(display_mount.posts)
        intrusions |= {f"display post {i + 1}": p for i, p in enumerate(display_mount.posts)}

    markings = _markings(lay, top_out)
    shell -= Compound(cuts)
    shell -= markings
    shell.label = f"cover {name}"
    return Cover(
        part=cast(Part, shell),
        intrusions=intrusions,
        display=display_part,
        markings=markings,
        button=_button(lay, name, top_in, top_out),
        fasteners=lay.fasteners,
        display_mount=display_mount,
    )


def _display(lay: Layout, d: Display, top_in: float, top_out: float) -> tuple[Part, Part]:
    """Window and module envelope, including clear mounting corners."""
    pw, pd, pt = d.pcb
    x = lay.display_x
    y = 0.0  # board centre; clears the front mounting pillars
    ax, ay, aw, ah = d.active
    w, h = aw + 2 * WINDOW_MARGIN, ah + 2 * WINDOW_MARGIN
    window = extrude(Pos(x + ax, y + ay, top_in - 1) * Rectangle(w, h), amount=TOP + 2)
    bevel = Pos(x + ax, y + ay, top_out - WINDOW_BEVEL) * Rectangle(w, h)
    window += extrude(bevel, amount=WINDOW_BEVEL + 1, taper=-45)

    gx, gy, gw, gh, gt = d.glass
    face = top_in - GLASS_GAP - gt  # the module PCB's top face
    module = Pos(x, y, face) * Box(pw, pd, pt, align=(Align.CENTER, Align.CENTER, Align.MAX))
    for hx, hy in d.holes:
        module -= Pos(x + hx, y + hy, face - pt - 0.1) * Cylinder(
            DISPLAY_HOLE_D / 2, pt + 0.2, align=BASE
        )
    back = Pos(x, y, face - pt) * Box(pw, pd, d.back, align=(Align.CENTER, Align.CENTER, Align.MAX))
    # The vendor STEP leaves these mounting corners free of rear components and flex.
    for hx, hy in d.holes:
        back -= Pos(x + hx, y + hy, face - pt - d.back - 0.1) * Cylinder(
            3.8, d.back + 0.2, align=BASE
        )
    module += back
    module += Pos(x + gx, y + gy, face) * Box(gw, gh, gt, align=BASE)
    module.label = f"{d.name} envelope"
    return window, cast(Part, module)


def _wall_cut(o: Opening) -> Part:
    start = o.plane(o.y_wall - o.inward)  # 1 mm outside
    cut = extrude(start * o.profile(), amount=-(WALL + 2))
    if o.kind != "usb-c":
        return cast(Part, cut)
    # Round the outer edge on an unsplit slab of wall, then cut what the slab leaves of a
    # block that stops inside it, so the tray and cover halves share one profile.
    w, h = o.width + 2 * PORT_EDGE_R + 2, o.height + 2 * PORT_EDGE_R + 2
    slab = extrude(o.plane(o.y_wall) * Rectangle(w, h), amount=-2 * PORT_EDGE_R) - cut
    lip = [
        e
        for e in slab.edges()
        if abs(e.bounding_box().min.Y - o.y_wall) < 1e-4
        and abs(e.bounding_box().max.Y - o.y_wall) < 1e-4
        and abs(e.center().X - o.x) < o.width / 2 + 1e-3
        and abs(e.center().Z - o.z) < o.height / 2 + 1e-3
    ]
    slab = fillet(lip, PORT_EDGE_R)
    block = extrude(start * Rectangle(w - 0.2, h - 0.2), amount=-(1 + 1.5 * PORT_EDGE_R))
    return cast(Part, cut + (block - slab))


def _artwork(lay: Layout) -> list[Sketch]:
    """Top-face marks for connectors, status, controls and name."""
    host, power, first = (lay.board.box(ref).center() for ref in ("J901", "J1001", "J401"))
    status = lay.board.box("D1170").center()
    sw = lay.board.box(BUTTON).center()
    marks = [
        Pos(host.X, lay.y_rear - 7) * icon("laptop-minimal"),
        Pos(power.X, lay.y_rear - 7) * icon("plug"),
        Pos(first.X, lay.y_front + 7) * Circle(1),
        Pos(status.X, lay.y_front + 7) * icon("activity", size=5.5),
        Pos(lay.control_left + 15, sw.Y) * Text(WORDMARK, font_size=WORDMARK_SIZE),
    ]
    gesture_x = sw.X - (BUTTON_D / 2 + BUTTON_FIT) - 3 - 4.1
    label_right = gesture_x - 4.1 - 3
    for action, y in (("DFU", sw.Y + 6), ("REBOOT", sw.Y), ("RESTORE", sw.Y - 6)):
        marks.append(
            Pos(label_right, y)
            * Text(
                action,
                font_size=TEXT_SIZE,
                font_style=FontStyle.BOLD,
                align=(Align.MAX, Align.CENTER),
            )
        )
        if action == "DFU":
            marks.append(Pos(gesture_x, y) * Circle(0.6))
        elif action == "REBOOT":
            marks.append(Pos(gesture_x, y) * SlotOverall(3, 1.2))
        else:
            marks += [
                Pos(gesture_x - 3.5, y) * Circle(0.6),
                Pos(gesture_x - 1.1, y) * Circle(0.6),
                Pos(gesture_x + 2.6, y) * SlotOverall(3, 1.2),
            ]
    for ref, symbol in (("S:J401", "usb"), ("S:J501", "square-terminal")):
        if ref in lay.ports:
            marks.append(Pos(lay.board.box(ref).center().X, lay.y_rear - 7) * icon(symbol, size=8))
    return marks


def _markings(lay: Layout, top: float) -> Compound:
    marks = Compound([extrude(Pos(0, 0, top) * face, amount=-TEXT_DEPTH) for face in _artwork(lay)])
    marks.label = "markings"
    return marks


def _button(lay: Layout, name: str, top_in: float, top_out: float) -> Part:
    """Separate cap inserted from inside; the flange retains it and the switch returns it."""
    sb = lay.board.box(BUTTON)
    sw = sb.center()
    flange_top = top_in - BUTTON_ROOF_GAP
    flange_bottom = flange_top - BUTTON_FLANGE_H
    pin_bottom = sb.max.Z
    cap = Pos(sw.X, sw.Y, flange_top) * Cylinder(
        BUTTON_D / 2, top_out + BUTTON_PROUD - flange_top, align=BASE
    )
    cap += Pos(sw.X, sw.Y, flange_bottom) * Cone(
        BUTTON_FLANGE_D / 2, BUTTON_D / 2, BUTTON_FLANGE_H, align=BASE
    )
    cap += Pos(sw.X, sw.Y, pin_bottom) * Cylinder(
        BUTTON_PIN / 2, flange_bottom - pin_bottom + 0.1, align=BASE
    )
    cap.label = f"button {name}"
    return cast(Part, cap)


def _roof_openings(lay: Layout) -> list[Sketch]:
    """Open rear notches let the Ethernet shell reach the top plane."""
    openings = []
    for ref, (kind, _) in lay.ports.items():
        if kind != "rj45":
            continue
        bb = lay.board.box(ref)
        front, rear = bb.min.Y - PORT_FIT, lay.y_rear + 1
        openings.append(
            Pos(bb.center().X, (front + rear) / 2)
            * Rectangle(bb.size.X + 2 * PORT_FIT, rear - front)
        )
    return openings


def _display_keepout(lay: Layout, display: Display) -> Sketch:
    return Pos(lay.display_x, 0) * Rectangle(display.pcb[0] + 4, display.pcb[1] + 4)


def _control_grooves(lay: Layout, top: float, display: Display | None) -> list[Part]:
    grooves = []
    left, right = lay.control_left, lay.length / 2 - 10
    for y in (2, -21):
        profile = Pos((left + right) / 2, y) * SlotOverall(right - left, 0.8)
        if display:
            profile = Sketch((profile - _display_keepout(lay, display)).faces())
        grooves.append(extrude(Pos(0, 0, top - 0.4) * profile, amount=0.6))
    if lay.divider_x is not None:
        profile = Pos(lay.divider_x, 0) * RectangleRounded(0.8, lay.width - 20, 0.39)
        grooves.append(extrude(Pos(0, 0, top - 0.4) * profile, amount=0.6))
    return grooves


def _side_intakes(lay: Layout) -> list[Part]:
    cuts = []
    for x in (-lay.length / 2, lay.length / 2):
        for y in (-24, 0, 24):
            plane = Plane(origin=(x - 2, y, 6), x_dir=(0, 1, 0), z_dir=(1, 0, 0))
            cuts.append(extrude(plane * SlotOverall(10, 2.8), amount=4))
    return cuts


def _top_slots(lay: Layout, z: float, depth: float, display: Display | None) -> list[Part]:
    """Horizontal vent bands around a continuous control strip."""
    avoid = [f.bounding_box() for f in _artwork(lay)]
    avoid += [p.bounding_box() for p in _roof_openings(lay)]
    bb = lay.board.box(BUTTON)
    avoid.append(
        (Pos(bb.center().X, bb.center().Y) * Circle(BUTTON_FLANGE_D / 2 + MIN_GAP)).bounding_box()
    )
    if display:
        avoid.append(_display_keepout(lay, display).bounding_box())
    slots = []
    rows = (12, 18, 24, 30, 36, -32, -37)
    left, right = -lay.length / 2 + 12, lay.length / 2 - 12
    zones = (
        [(left, right, rows)]
        if lay.divider_x is None
        else [
            (left, lay.divider_x - 5, range(-24, 25, 6)),
            (lay.divider_x + 5, right, rows),
        ]
    )
    for left, right, bands in zones:
        span = right - left
        count = math.ceil(span / 18)
        length = (span - 2 * (count - 1)) / count
        for y in bands:
            for i in range(count):
                x = left + length / 2 + i * (length + 2)
                profile = Pos(x, y, z) * SlotOverall(length, SLOT_W)
                b = profile.bounding_box()
                if any(
                    b.min.X < a.max.X + 2
                    and b.max.X > a.min.X - 2
                    and b.min.Y < a.max.Y + 2
                    and b.max.Y > a.min.Y - 2
                    for a in avoid
                ):
                    continue
                slots.append(extrude(profile, amount=depth))
    return slots


BOARDS = Path(__file__).resolve().parents[4] / "build" / "boards" / "iasis"
STEP = BOARDS / "board.step"  # HubPD, which fits Hub too


def assemble(
    *, cover_names: tuple[str, ...] = tuple(COVERS)
) -> tuple[Layout, Part, dict[str, Cover]]:
    lay = layout(load(STEP))
    covers = {name: cover(lay, name, COVERS[name]) for name in cover_names}
    return lay, tray(lay), covers


def assemble_cm5(
    *, cover_names: tuple[str, ...] = tuple(COVERS)
) -> tuple[Layout, Part, dict[str, Cover]]:
    """The CM5 build: one tray and cover for the main board and the CM5 side board."""
    main = load(STEP)
    both = pair(main, side_board(main))
    lay = layout(both, ports=PORTS | SIDE_PORTS)
    lay.battery = battery_seat(both, lay.z_bottom + FLOOR)
    covers = {name: cover(lay, name, COVERS[name]) for name in cover_names}
    return lay, tray(lay), covers


def main() -> None:
    import argparse

    from .viewer import show

    parser = argparse.ArgumentParser(description=__doc__)
    parser.add_argument("--cm5", action="store_true", help="show the CM5 build instead")
    args = parser.parse_args()
    show(*(assemble_cm5() if args.cm5 else assemble()))


if __name__ == "__main__":
    main()
