hydazz/iasis/(commit log)

2026-10-29 chore(mise): update tool uv (0.12.20 → 0.13.5) (#9)
2026-11-01 chore(github-action): update action jdx/mise-action (v5.2.3 → v5.2.4) (#12)
2026-11-01 chore(mise): update tool oxfmt (0.74.0 → 0.75.0) (#13)
2026-11-01 fix(rust): update crate zip (9.1.2 → 9.1.3) (#14)
2026-11-01 chore(mise): update tool node (26.12.1 → v26.13.0) (#15)
2026-11-01 fix(hardware): replace side-link socket with C19268939
    Update J2001 supplier fields, mechanical model, outlines, placement correction and preview while retaining its pad pattern and copper.
2026-11-01 fix(hardware): improve supply margins and USB pair matching
    Adjust the main core and CM5 accessory supplies, including the core feed-forward capacitor. Match complete USB TX paths across coupling capacitors and muxes.
    Charge presence power against the active brick supply and reserve 35 W for the CM5 carrier. Refresh the board preview.
2026-11-01 chore(mise): update tool aqua:jdx/jactionlint (2.3.0 → 2.4.0) (#18)
2026-11-02 feat(hardware): add CM5 RTC battery
2026-11-02 chore(github-action): update action kicad/kicad (10.0.7 → 10.0.8) (#19)
2026-11-03 chore(github-action): update action jdx/mise-action (v5.2.4 → v5.2.5) (#20)
2026-11-04 fix(rust): update crate zip (9.2.0 → 9.2.1) (#21)
2026-11-05 fix(rust): update crate zip (9.2.1 → 9.2.2) (#22)
2026-11-06 chore(github-action): update action jdx/mise-action (v5.2.5 → v5.2.6) (#23)
2026-11-06 chore(mise): update tool uv (0.13.6 → 0.13.7) (#24)
2026-11-06 feat(rust): update crate zip (9.2.2 → 9.3.0) (#25)
2026-11-06 feat(rust): update crate zip (9.3.0 → 9.4.0) (#26)
2026-11-07 fix(rust): update crate zip (9.4.0 → 9.4.1) (#28)
2026-11-09 fix(rust): update crate zip (9.4.1 → 9.4.2) (#29)
2026-11-09 chore(github-action): update action jdx/mise-action (v5.2.6 → v5.2.7) (#30)
2026-11-10 feat(rust): update crate zip (9.4.2 → 9.5.0) (#31)
2026-11-10 fix(cm5): move the left mounting holes to 3 mm from the edge
2026-11-10 feat(case): fasten the shell with M3 screws
    Four M3 x 15 mm screws pass from underneath into nuts captive in the
    lid's outer posts, replacing the snap catches. The OLED screws to its
    posts with M2.5 screws, and stick-on rubber feet replace the TPU feet.
2026-11-12 fix(rust): update crate zip (9.5.0 → 9.5.1) (#33)
2026-11-12 chore(mise): update tool node (26.13.0 → v26.13.1) (#32)
2026-11-13 chore(mise): update tool rust (1.99.1 → 1.100.0) (#34)
